sullin/thermometer-hw/v1.0/outputs/thermometer-brd.pdf

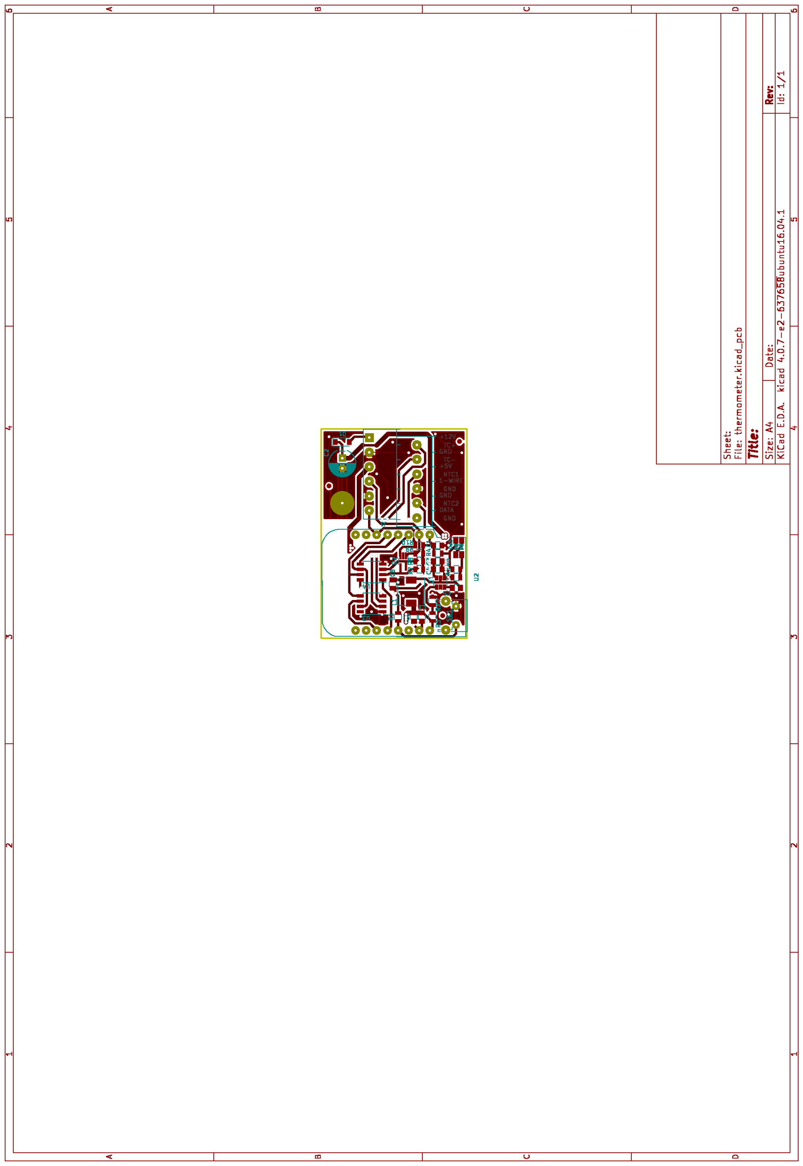
[picture p1: page 1]
