sullin/thermometer-hw/v2.0/outputs-20220826/thermometer-hw2.csv

Source: | /home/anti/Development_backup/thermometer/thermometer-hw2/thermometer-hw2/thermometer-hw2.kicad_sch
Date: | L 27 aug 2022 00:02:45
Tool: | Eeschema 6.0.7-f9a2dced07~116~ubuntu20.04.1
Generator: | /usr/share/kicad/plugins/bom_csv_grouped_by_value.py
Component Count: | 27
Individual Components:
Item | Qty | Reference(s) | Value | LibPart | Footprint | Datasheet
 |  | C1 | 220uF 25V | Device:C_Polarized | Capacitor_THT:CP_Radial_D8.0mm_P3.50mm | ~
 |  | C2 | 10uF 25V 1210 | Device:C | Capacitor_SMD:C_0805_2012Metric_Pad1.18x1.45mm_HandSolder | ~
 |  | C3 | 100nF | Device:C | Capacitor_SMD:C_0805_2012Metric_Pad1.18x1.45mm_HandSolder | ~
 |  | C4 | 22uF 10V 1210 | Device:C | Capacitor_SMD:C_0805_2012Metric_Pad1.18x1.45mm_HandSolder | ~
 |  | C5 | 22uF 10V 1210 | Device:C | Capacitor_SMD:C_0805_2012Metric_Pad1.18x1.45mm_HandSolder | ~
 |  | C6 | 100nF | Device:C | Capacitor_SMD:C_0805_2012Metric_Pad1.18x1.45mm_HandSolder | ~
 |  | C7 | 100nF | Device:C | Capacitor_SMD:C_0805_2012Metric_Pad1.18x1.45mm_HandSolder | ~
 |  | D1 | PMEG40T30ER | Diode:PMEG40T30ER | Diode_SMD:Nexperia_CFP3_SOD-123W | https://assets.nexperia.com/documents/data-sheet/PMEG40T30ER.pdf
 |  | D2 | 0603 RED | Device:LED | LED_SMD:LED_0805_2012Metric_Pad1.15x1.40mm_HandSolder | ~
 |  | D3 | 0603 GRN | Device:LED | LED_SMD:LED_0805_2012Metric_Pad1.15x1.40mm_HandSolder | ~
 |  | D4 | PESD3V3L4UG | Power_Protection:PESD3V3L4UG | Package_TO_SOT_SMD:SOT-353_SC-70-5 | https://assets.nexperia.com/documents/data-sheet/PESDXL4UF_G_W.pdf
 |  | J1 | MKKDS_1_6_3.5 | th_hw2:MKKDS_1_6_3.5 | th_hw2:PHO_MKKDS_1_6_3.5
 |  | L1 | 1.5uH | Device:L | Inductor_SMD:L_1008_2520Metric_Pad1.43x2.20mm_HandSolder | ~
 |  | R1 | 10K | Device:R | Resistor_SMD:R_0805_2012Metric_Pad1.20x1.40mm_HandSolder | ~
 |  | R2 | 10k | Device:R | Resistor_SMD:R_0805_2012Metric_Pad1.20x1.40mm_HandSolder | ~
 |  | R3 | 52.3k | Device:R | Resistor_SMD:R_0805_2012Metric_Pad1.20x1.40mm_HandSolder | ~
 |  | R4 | 120 | Device:R | Resistor_SMD:R_0805_2012Metric_Pad1.20x1.40mm_HandSolder | ~
 |  | R5 | 120 | Device:R | Resistor_SMD:R_0805_2012Metric_Pad1.20x1.40mm_HandSolder | ~
 |  | R6 | 10K | Device:R | Resistor_SMD:R_0805_2012Metric_Pad1.20x1.40mm_HandSolder | ~
 |  | R7 | 10K | Device:R | Resistor_SMD:R_0805_2012Metric_Pad1.20x1.40mm_HandSolder | ~
 |  | R8 | 4K7 | Device:R | Resistor_SMD:R_0805_2012Metric_Pad1.20x1.40mm_HandSolder | ~
 |  | R9 | 4K7 | Device:R | Resistor_SMD:R_0805_2012Metric_Pad1.20x1.40mm_HandSolder | ~
 |  | SW1 | SW_Push | Switch:SW_Push | Button_Switch_THT:SW_Tactile_SPST_Angled_PTS645Vx31-2LFS | ~
 |  | U1 | WeMos_D1_mini | MCU_Module:WeMos_D1_mini | th_hw2:WEMOS_D1_mini_light_flip | https://wiki.wemos.cc/products:d1:d1_mini#documentation
 |  | U2 | AP62300WU | th_hw2:AP62300WU | Package_TO_SOT_SMD:TSOT-23-6 | https://www.diodes.com/assets/Datasheets/AP62300_AP62301_AP62300T.pdf
 |  | U3 | MCP3002 | Analog_ADC:MCP3002 | Package_SO:SOIC-8_3.9x4.9mm_P1.27mm | http://ww1.microchip.com/downloads/en/DeviceDoc/21294E.pdf
 |  | U4 | MAX31855KASA | Sensor_Temperature:MAX31855KASA | Package_SO:SOIC-8_3.9x4.9mm_P1.27mm | http://datasheets.maximintegrated.com/en/ds/MAX31855.pdf
Collated Components:
Item | Qty | Reference(s) | Value | LibPart | Footprint | Datasheet
1 | 1 | C1 | 220uF 25V | Device:C_Polarized | Capacitor_THT:CP_Radial_D8.0mm_P3.50mm | ~
2 | 1 | C2 | 10uF 25V 1210 | Device:C | Capacitor_SMD:C_0805_2012Metric_Pad1.18x1.45mm_HandSolder | ~
3 | 3 | C3, C6, C7 | 100nF | Device:C | Capacitor_SMD:C_0805_2012Metric_Pad1.18x1.45mm_HandSolder | ~
4 | 2 | C4, C5 | 22uF 10V 1210 | Device:C | Capacitor_SMD:C_0805_2012Metric_Pad1.18x1.45mm_HandSolder | ~
5 | 1 | D1 | PMEG40T30ER | Diode:PMEG40T30ER | Diode_SMD:Nexperia_CFP3_SOD-123W | https://assets.nexperia.com/documents/data-sheet/PMEG40T30ER.pdf
6 | 1 | D2 | 0603 RED | Device:LED | LED_SMD:LED_0805_2012Metric_Pad1.15x1.40mm_HandSolder | ~
7 | 1 | D3 | 0603 GRN | Device:LED | LED_SMD:LED_0805_2012Metric_Pad1.15x1.40mm_HandSolder | ~
8 | 1 | D4 | PESD3V3L4UG | Power_Protection:PESD3V3L4UG | Package_TO_SOT_SMD:SOT-353_SC-70-5 | https://assets.nexperia.com/documents/data-sheet/PESDXL4UF_G_W.pdf
9 | 1 | J1 | MKKDS_1_6_3.5 | th_hw2:MKKDS_1_6_3.5 | th_hw2:PHO_MKKDS_1_6_3.5
10 | 1 | L1 | 1.5uH | Device:L | Inductor_SMD:L_1008_2520Metric_Pad1.43x2.20mm_HandSolder | ~
11 | 3 | R1, R6, R7 | 10K | Device:R | Resistor_SMD:R_0805_2012Metric_Pad1.20x1.40mm_HandSolder | ~
12 | 1 | R2 | 10k | Device:R | Resistor_SMD:R_0805_2012Metric_Pad1.20x1.40mm_HandSolder | ~
13 | 1 | R3 | 52.3k | Device:R | Resistor_SMD:R_0805_2012Metric_Pad1.20x1.40mm_HandSolder | ~
14 | 2 | R4, R5 | 120 | Device:R | Resistor_SMD:R_0805_2012Metric_Pad1.20x1.40mm_HandSolder | ~
15 | 2 | R8, R9 | 4K7 | Device:R | Resistor_SMD:R_0805_2012Metric_Pad1.20x1.40mm_HandSolder | ~
16 | 1 | SW1 | SW_Push | Switch:SW_Push | Button_Switch_THT:SW_Tactile_SPST_Angled_PTS645Vx31-2LFS | ~
17 | 1 | U1 | WeMos_D1_mini | MCU_Module:WeMos_D1_mini | th_hw2:WEMOS_D1_mini_light_flip | https://wiki.wemos.cc/products:d1:d1_mini#documentation
18 | 1 | U2 | AP62300WU | th_hw2:AP62300WU | Package_TO_SOT_SMD:TSOT-23-6 | https://www.diodes.com/assets/Datasheets/AP62300_AP62301_AP62300T.pdf
19 | 1 | U3 | MCP3002 | Analog_ADC:MCP3002 | Package_SO:SOIC-8_3.9x4.9mm_P1.27mm | http://ww1.microchip.com/downloads/en/DeviceDoc/21294E.pdf
20 | 1 | U4 | MAX31855KASA | Sensor_Temperature:MAX31855KASA | Package_SO:SOIC-8_3.9x4.9mm_P1.27mm | http://datasheets.maximintegrated.com/en/ds/MAX31855.pdf
