sullin/thermometer-hw/v2.0/outputs-20220826/thermometer-v2-pcb.pdf

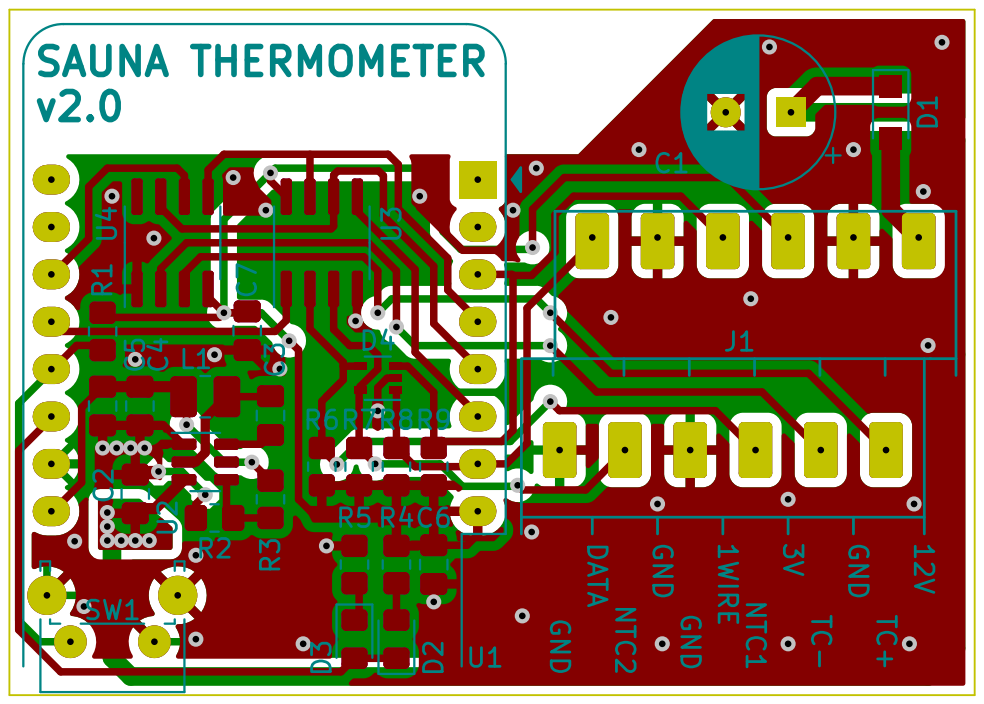
[picture p9: page 1]
