sullin/thermometer-hw/v2.0/outputs-20220826/thermometer-v2-sch.pdf

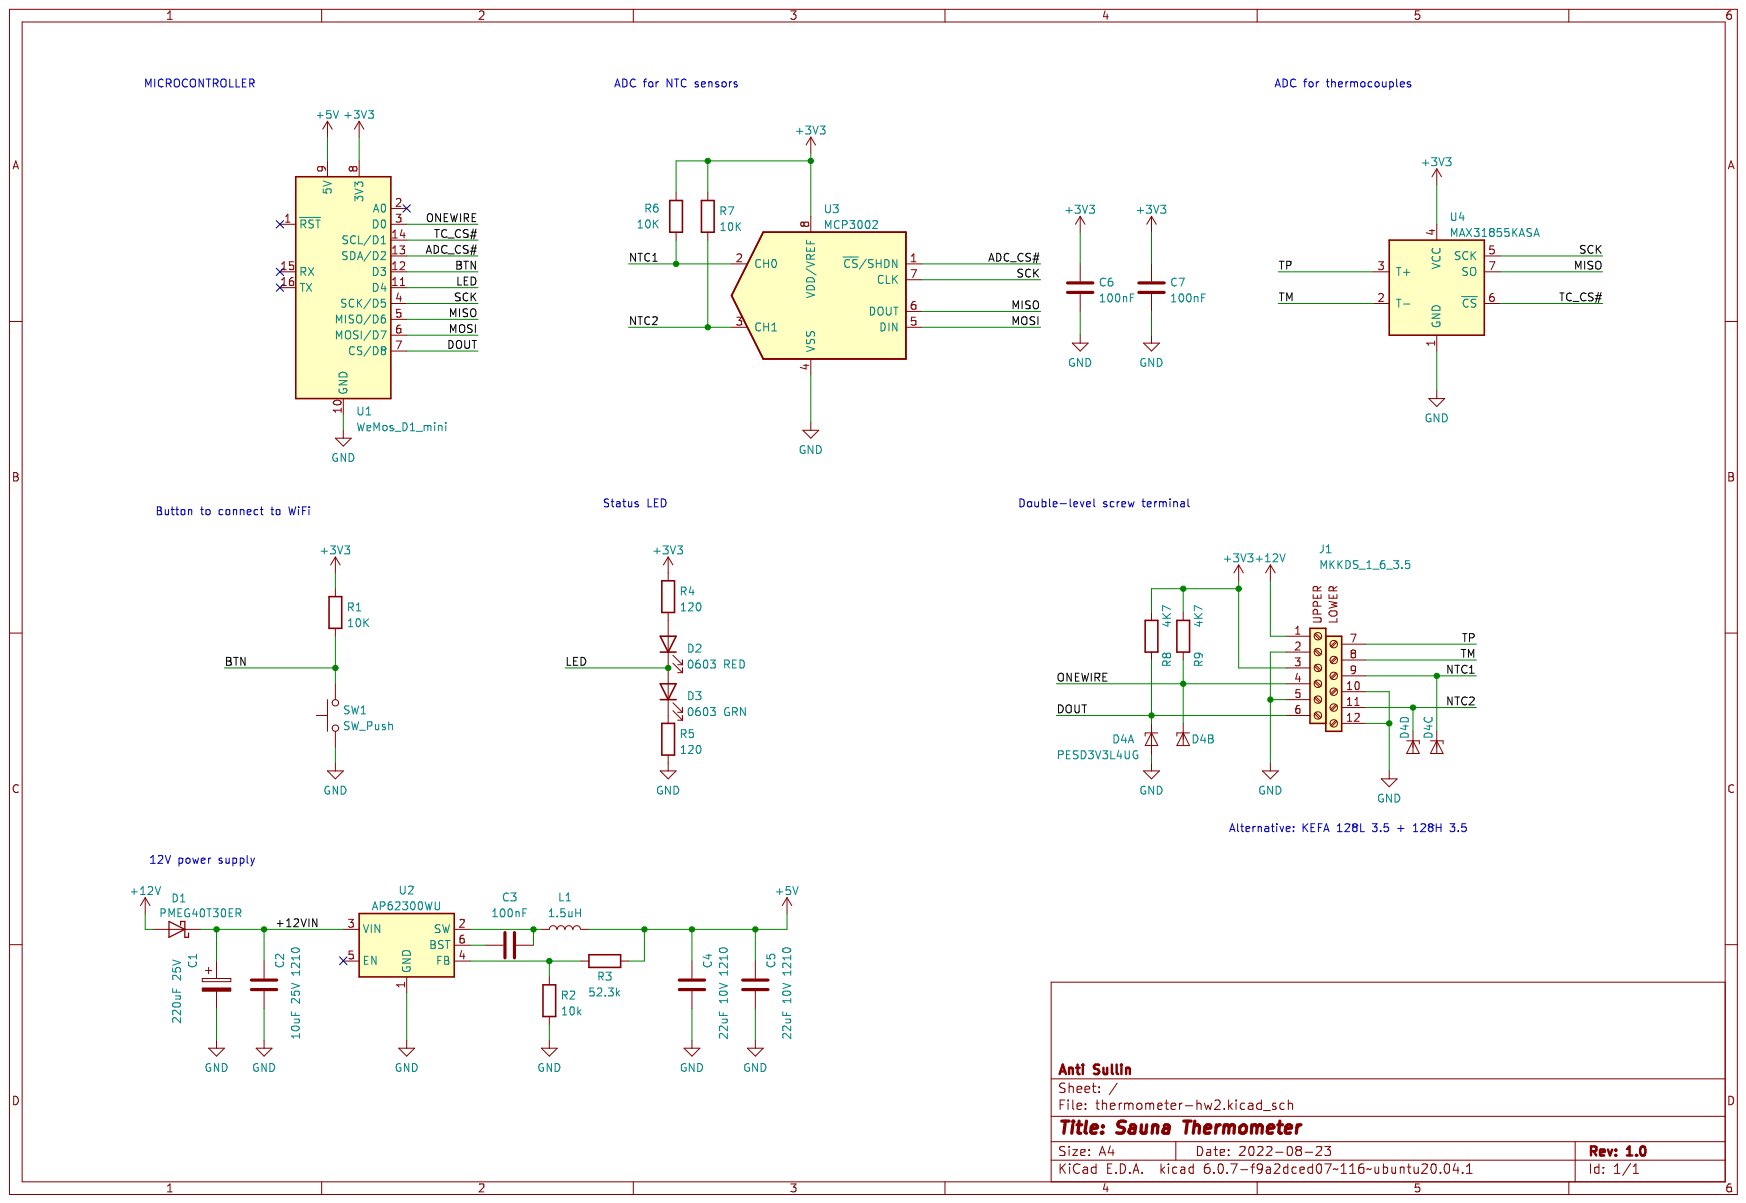
[picture p10: page 1]
