sullin/thermometer-hw/v1.0/outputs/thermometer-v1.0.pdf

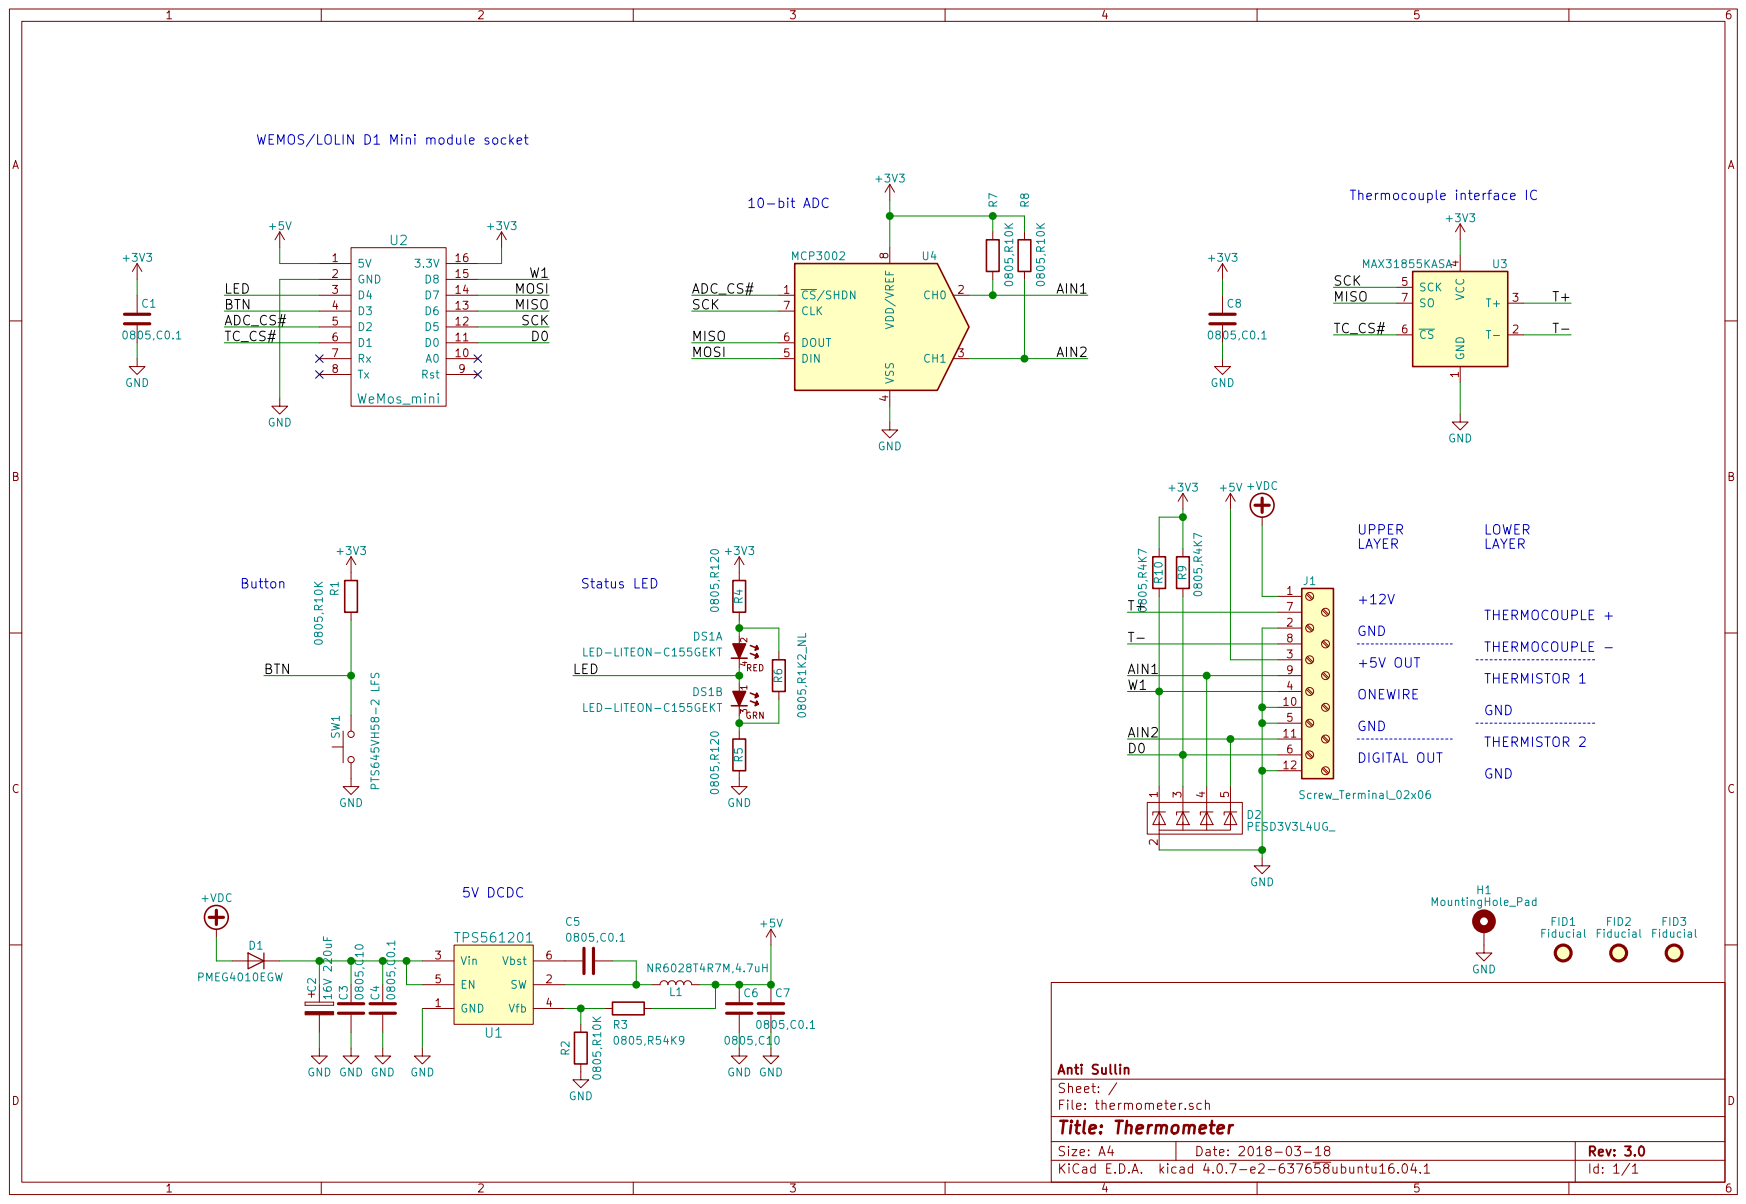
[picture p11: page 1]
