sullin/thermometer-hw/v2.0/thermometer-hw2.kicad_pcb

## KiCad design v2.0/thermometer-hw2.kicad_pcb (2022-09-06)

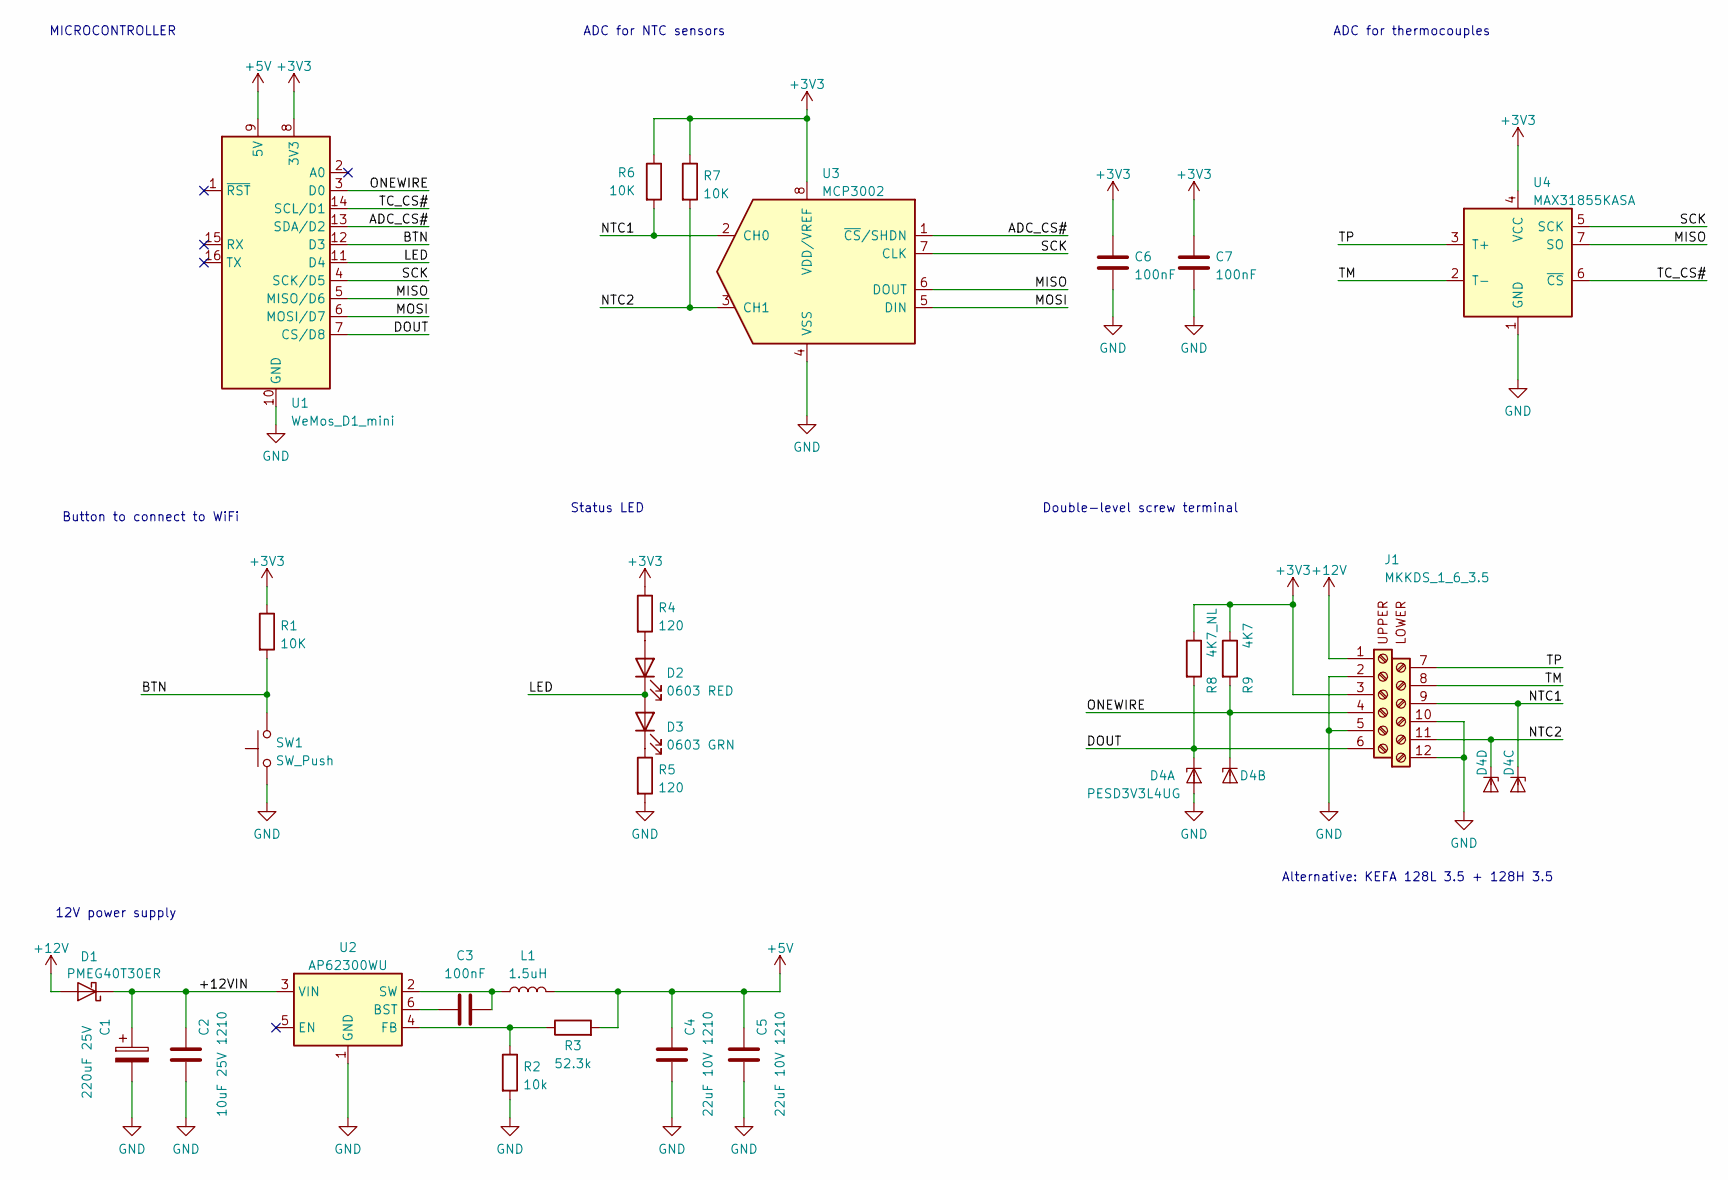
[picture p12: schematic thermometer-hw2.kicad_sch, Sauna Thermometer]

Parts:
C1: 220uF 25V; CP_Radial_D8.0mm_P3.50mm
C2: 10uF 25V 1210; C_0805_2012Metric_Pad1.18x1.45mm_HandSolder
C3, C6, C7: 100nF; C_0805_2012Metric_Pad1.18x1.45mm_HandSolder
C4, C5: 22uF 10V 1210; C_0805_2012Metric_Pad1.18x1.45mm_HandSolder
D1: PMEG40T30ER; Nexperia_CFP3_SOD-123W
D2: 0603 RED; LED_0805_2012Metric_Pad1.15x1.40mm_HandSolder
D3: 0603 GRN; LED_0805_2012Metric_Pad1.15x1.40mm_HandSolder
D4: PESD3V3L4UG; SOT-353_SC-70-5
J1: MKKDS_1_6_3.5; PHO_MKKDS_1_6_3.5
L1: 1.5uH; L_1008_2520Metric_Pad1.43x2.20mm_HandSolder
R1, R6, R7: 10K; R_0805_2012Metric_Pad1.20x1.40mm_HandSolder
R2: 10k; R_0805_2012Metric_Pad1.20x1.40mm_HandSolder
R3: 52.3k; R_0805_2012Metric_Pad1.20x1.40mm_HandSolder
R4, R5: 120; R_0805_2012Metric_Pad1.20x1.40mm_HandSolder
R8: 4K7_NL; R_0805_2012Metric_Pad1.20x1.40mm_HandSolder
R9: 4K7; R_0805_2012Metric_Pad1.20x1.40mm_HandSolder
SW1: SW_Push; SW_Tactile_SPST_Angled_PTS645Vx31-2LFS
U1: WeMos_D1_mini; WEMOS_D1_mini_light_flip
U2: AP62300WU; TSOT-23-6
U3: MCP3002; SOIC-8_3.9x4.9mm_P1.27mm
U4: MAX31855KASA; SOIC-8_3.9x4.9mm_P1.27mm

Connections:
+3V3: C6.1, C7.1, J1.3, R1.1, R4.1, R6.1, R7.1, R8.1, R9.1, U1.8 (3V3), U3.8 (VDD/VREF), U4.4 (VCC)
+5V: C4.1, C5.1, L1.2, R3.2, U1.9 (5V)
+12V: D1.2 (A), J1.1
/+12VIN: C1.1, C2.1, D1.1 (K), U2.3 (VIN)
/ADC_CS#: U1.13 (SDA/D2), U3.1 (~CS/SHDN)
/BTN: R1.2, SW1.2, U1.12 (D3)
/DOUT: D4.1 (K1), J1.6, R8.2, U1.7 (CS/D8)
/LED: D2.1 (K), D3.2 (A), U1.11 (D4)
/MISO: U1.5 (MISO/D6), U3.6 (DOUT), U4.7 (SO)
/MOSI: U1.6 (MOSI/D7), U3.5 (DIN)
/NTC1: D4.4 (K3), J1.9, R6.2, U3.2 (CH0)
/NTC2: D4.5 (K4), J1.11, R7.2, U3.3 (CH1)
/ONEWIRE: D4.3 (K2), J1.4, R9.2, U1.3 (D0)
/SCK: U1.4 (SCK/D5), U3.7 (CLK), U4.5 (SCK)
/TC_CS#: U1.14 (SCL/D1), U4.6 (~CS)
/TM: J1.8, U4.2 (T-)
/TP: J1.7, U4.3 (T+)
GND: C1.2, C2.2, C4.2, C5.2, C6.2, C7.2, D4.2 (A), J1.2, J1.5, J1.10, J1.12, R2.2, R5.2, SW1.1, U1.10 (GND), U2.1 (GND), U3.4 (VSS), U4.1 (GND)
unnamed: C3.1, U2.6 (BST)
unnamed: C3.2, L1.1, U2.2 (SW)
unnamed: D2.2 (A), R4.2
unnamed: D3.1 (K), R5.1
unnamed: R2.1, R3.1, U2.4 (FB)

Notes on the sheet:
Button to connect to WiFi
MICROCONTROLLER
12V power supply
Status LED
ADC for NTC sensors
Double-level screw terminal
ADC for thermocouples
Alternative: KEFA 128L 3.5 + 128H 3.5

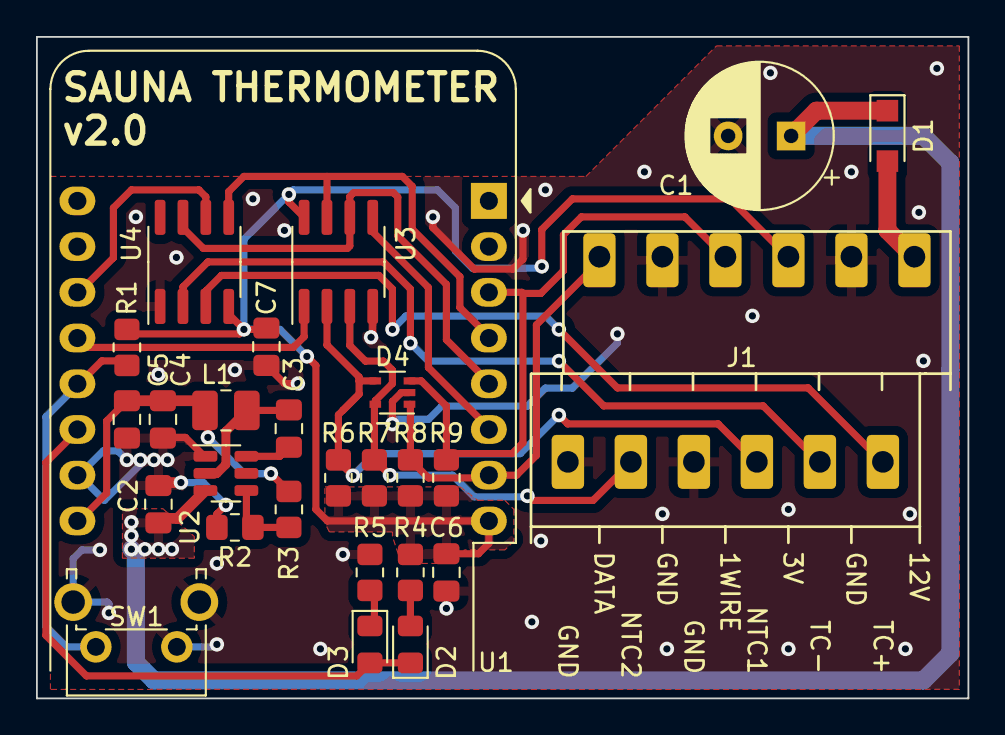
[picture p13: board thermometer-hw2.kicad_pcb from above]

Board: 2 copper layers, 51.8 x 36.8 mm, 27 parts (0 on the bottom side), 23 nets.
