sullin/thermometer-hw/v1.0/thermometer.kicad_pcb

## KiCad design v1.0/thermometer.kicad_pcb (2019-03-10, an earlier design)

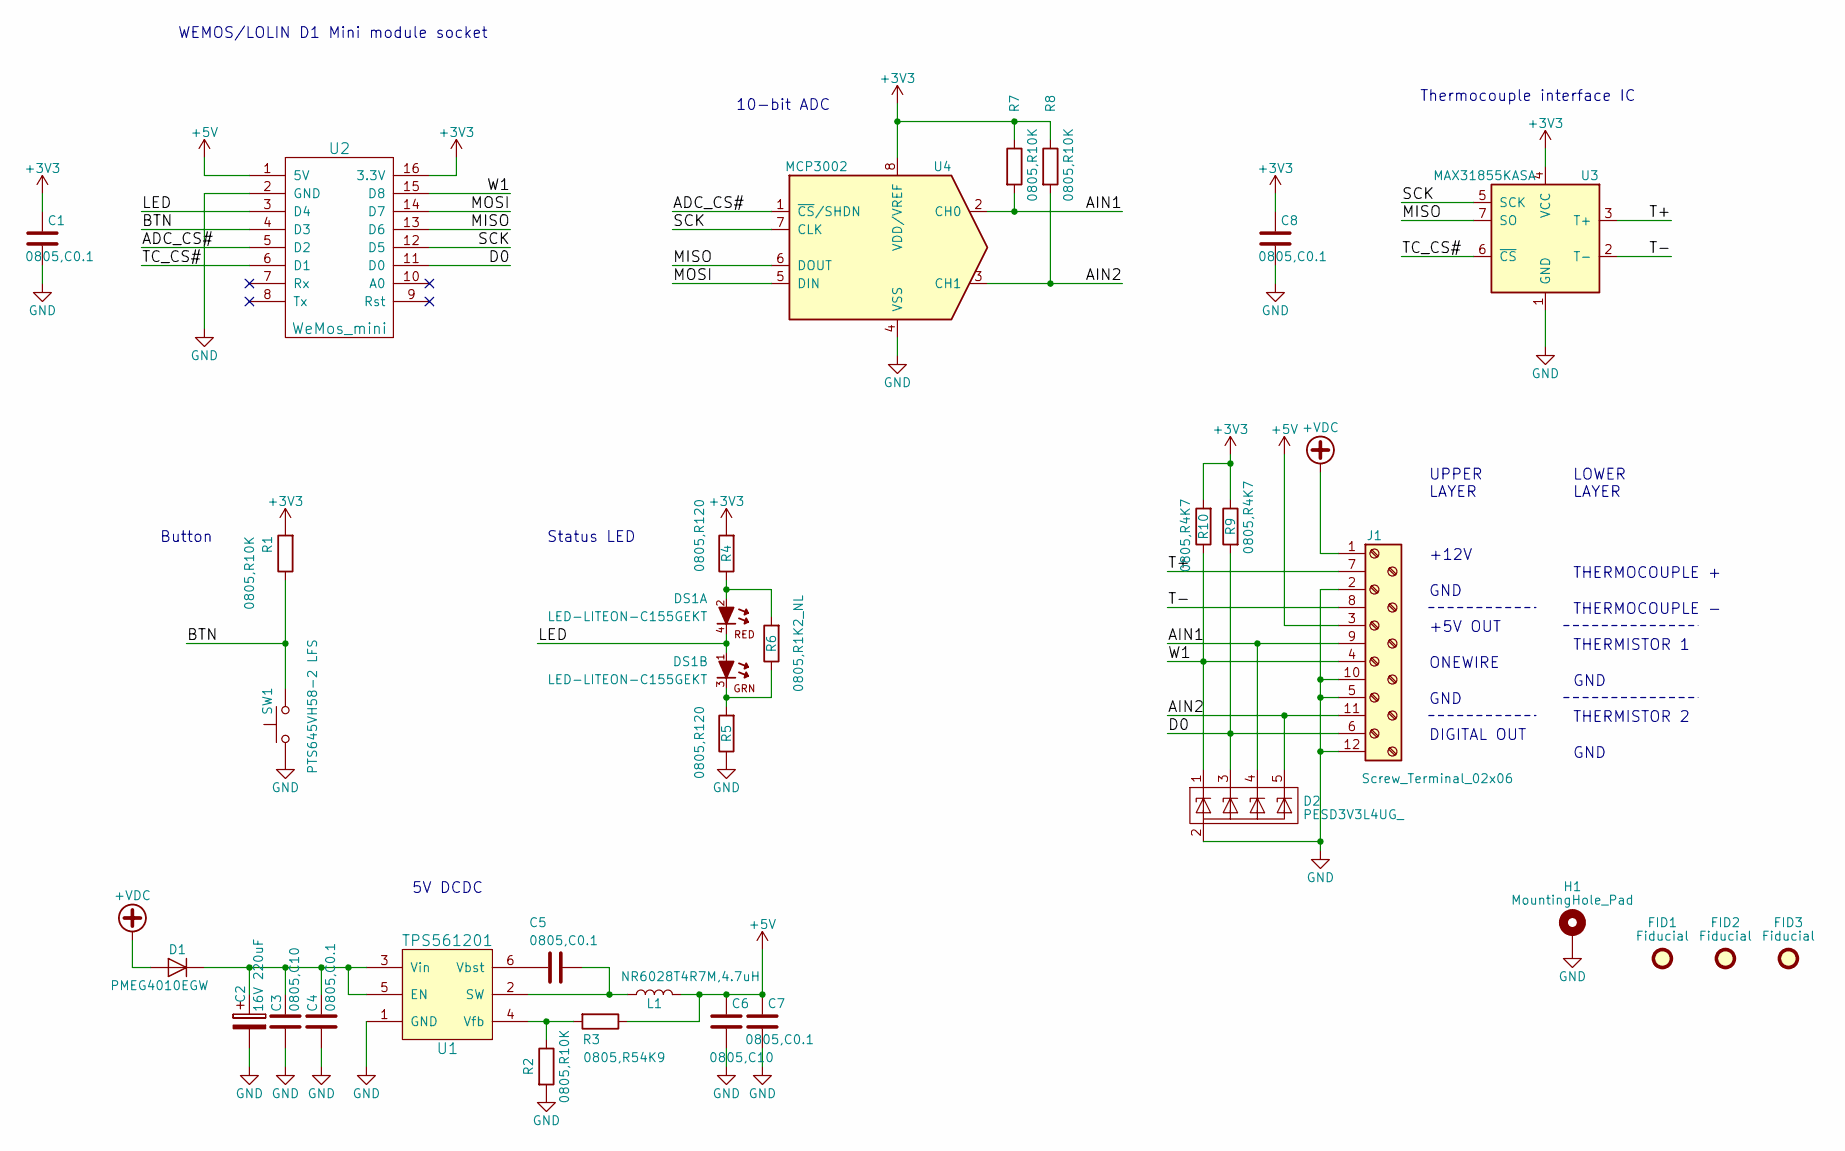
[picture p14: schematic thermometer.sch]

Parts:
C1, C4, C5, C7, C8: 0805,C0.1; C_0805
C2: 16V 220uF; CP_Radial_D6.3mm_P2.50mm
C3, C6: 0805,C10; C_0805
D1: PMEG4010EGW; D_SOD-123
D2: PESD3V3L4UG_; SOT-353_SC-70-5_Handsoldering
DS1: LED-LITEON-C155GEKT; LITEON-LED2-C155GEKT
FID1, FID2, FID3: Fiducial; Fiducial_1mm_Mask2mm
H1: MountingHole_Pad; MountingHole_3.2mm_M3_DIN965_Pad
J1: Screw_Terminal_02x06; PHO_MKKDS_1_12-3,5
L1: NR6028T4R7M,4.7uH; L_6.3x6.3_H3
R1, R2, R7, R8: 0805,R10K; R_0805
R3: 0805,R54K9; R_0805
R4, R5: 0805,R120; R_0805
R6: 0805,R1K2_NL; R_0805
R9, R10: 0805,R4K7; R_0805
SW1: PTS645VH58-2 LFS; SW_Tactile_SPST_Angled_PTS645Vx58-2LFS
U1: TPS561201; SOT-23-6
U2: WeMos_mini; D1_mini_board
U3: MAX31855KASA; SOIC-8_3.9x4.9mm_Pitch1.27mm
U4: MCP3002; SOIC-8_3.9x4.9mm_Pitch1.27mm

Connections:
+3V3: C1.1, C8.1, R1.2, R4.2, R7.1, R8.1, R9.1, R10.2, U2.16 (3.3V), U3.4 (VCC), U4.8 (VDD/VREF)
+5V: C6.1, C7.1, J1.3, L1.2, R3.1, U2.1 (5V)
+VDC: D1.2 (A), J1.1
/ADC_CS#: U2.5 (D2), U4.1 (~CS~/SHDN)
/AIN1: D2.4 (K3), J1.9, R7.2, U4.2 (CH0)
/AIN2: D2.5 (K4), J1.11, R8.2, U4.3 (CH1)
/BTN: R1.1, SW1.2, U2.4 (D3)
/D0: D2.3 (K2), J1.6, R9.2, U2.11 (D0)
/LED: DS1.1 (A), DS1.4 (K), U2.3 (D4)
/MISO: U2.13 (D6), U3.7 (SO), U4.6 (DOUT)
/MOSI: U2.14 (D7), U4.5 (DIN)
/SCK: U2.12 (D5), U3.5 (SCK), U4.7 (CLK)
/T+: J1.7, U3.3 (T+)
/T-: J1.8, U3.2 (T-)
/TC_CS#: U2.6 (D1), U3.6 (~CS~)
/W1: D2.1 (K1), J1.4, R10.1, U2.15 (D8)
GND: C1.2, C2.2, C3.2, C4.2, C6.2, C7.2, C8.2, D2.2 (A), H1.1, J1.2, J1.5, J1.10, J1.12, R2.2, R5.1, SW1.1, U1.1 (GND), U2.2 (GND), U3.1 (GND), U4.4 (VSS)
unnamed: C2.1, C3.1, C4.1, D1.1 (K), U1.3 (Vin), U1.5 (EN)
unnamed: C5.1, L1.1, U1.2 (SW)
unnamed: C5.2, U1.6 (Vbst)
unnamed: DS1.2 (A), R4.1, R6.2
unnamed: DS1.3 (K), R5.2, R6.1
unnamed: R2.1, R3.2, U1.4 (Vfb)

Notes on the sheet:
5V DCDC
Status LED
+12V
THERMISTOR 1
THERMISTOR 2
THERMOCOUPLE +
GND
ONEWIRE
DIGITAL OUT
+5V OUT
Button
WEMOS/LOLIN D1 Mini module socket
10-bit ADC
Thermocouple interface IC
UPPER LAYER
LOWER LAYER
THERMOCOUPLE -

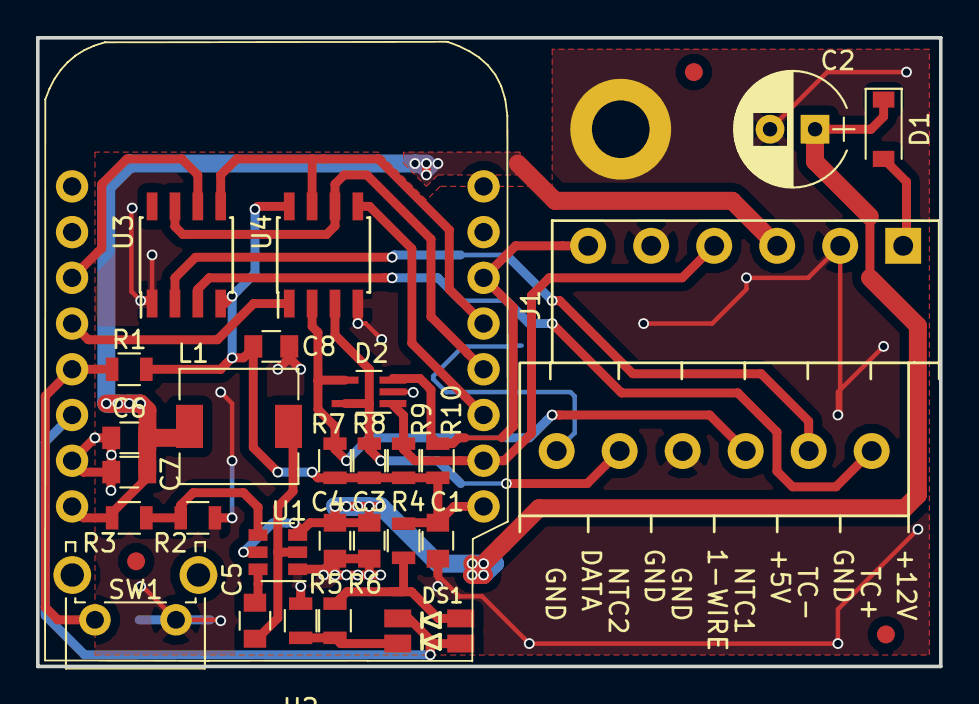
[picture p15: board thermometer.kicad_pcb from above]

Board: 2 copper layers, 50.2 x 34.9 mm, 32 parts (0 on the bottom side), 23 nets.
