sullin/thermometer-hw/(commit log)

2019-03-10 Initial import of v1.0
    [thermometer.kicad_pcb, thermometer.sch, thermometer_bom_v1.csv]
2022-09-06 reorganize git
    [thermometer.kicad_pcb, thermometer.sch, thermometer_bom_v1.csv]
2022-09-06 Add v2.0 board
    [thermometer-hw2.csv, thermometer-hw2.kicad_pcb, thermometer-hw2.kicad_sch]
